hyiger/sbc_z80/README.md

THS-80 Model I - a Z80 single board computer on a RC2014 form-factor card

Requires KiCad 5.1.4 or higher
