hyiger/sbc_z80/sbc_z80.kicad_pcb

## KiCad design sbc_z80.kicad_pcb (2019-09-01)

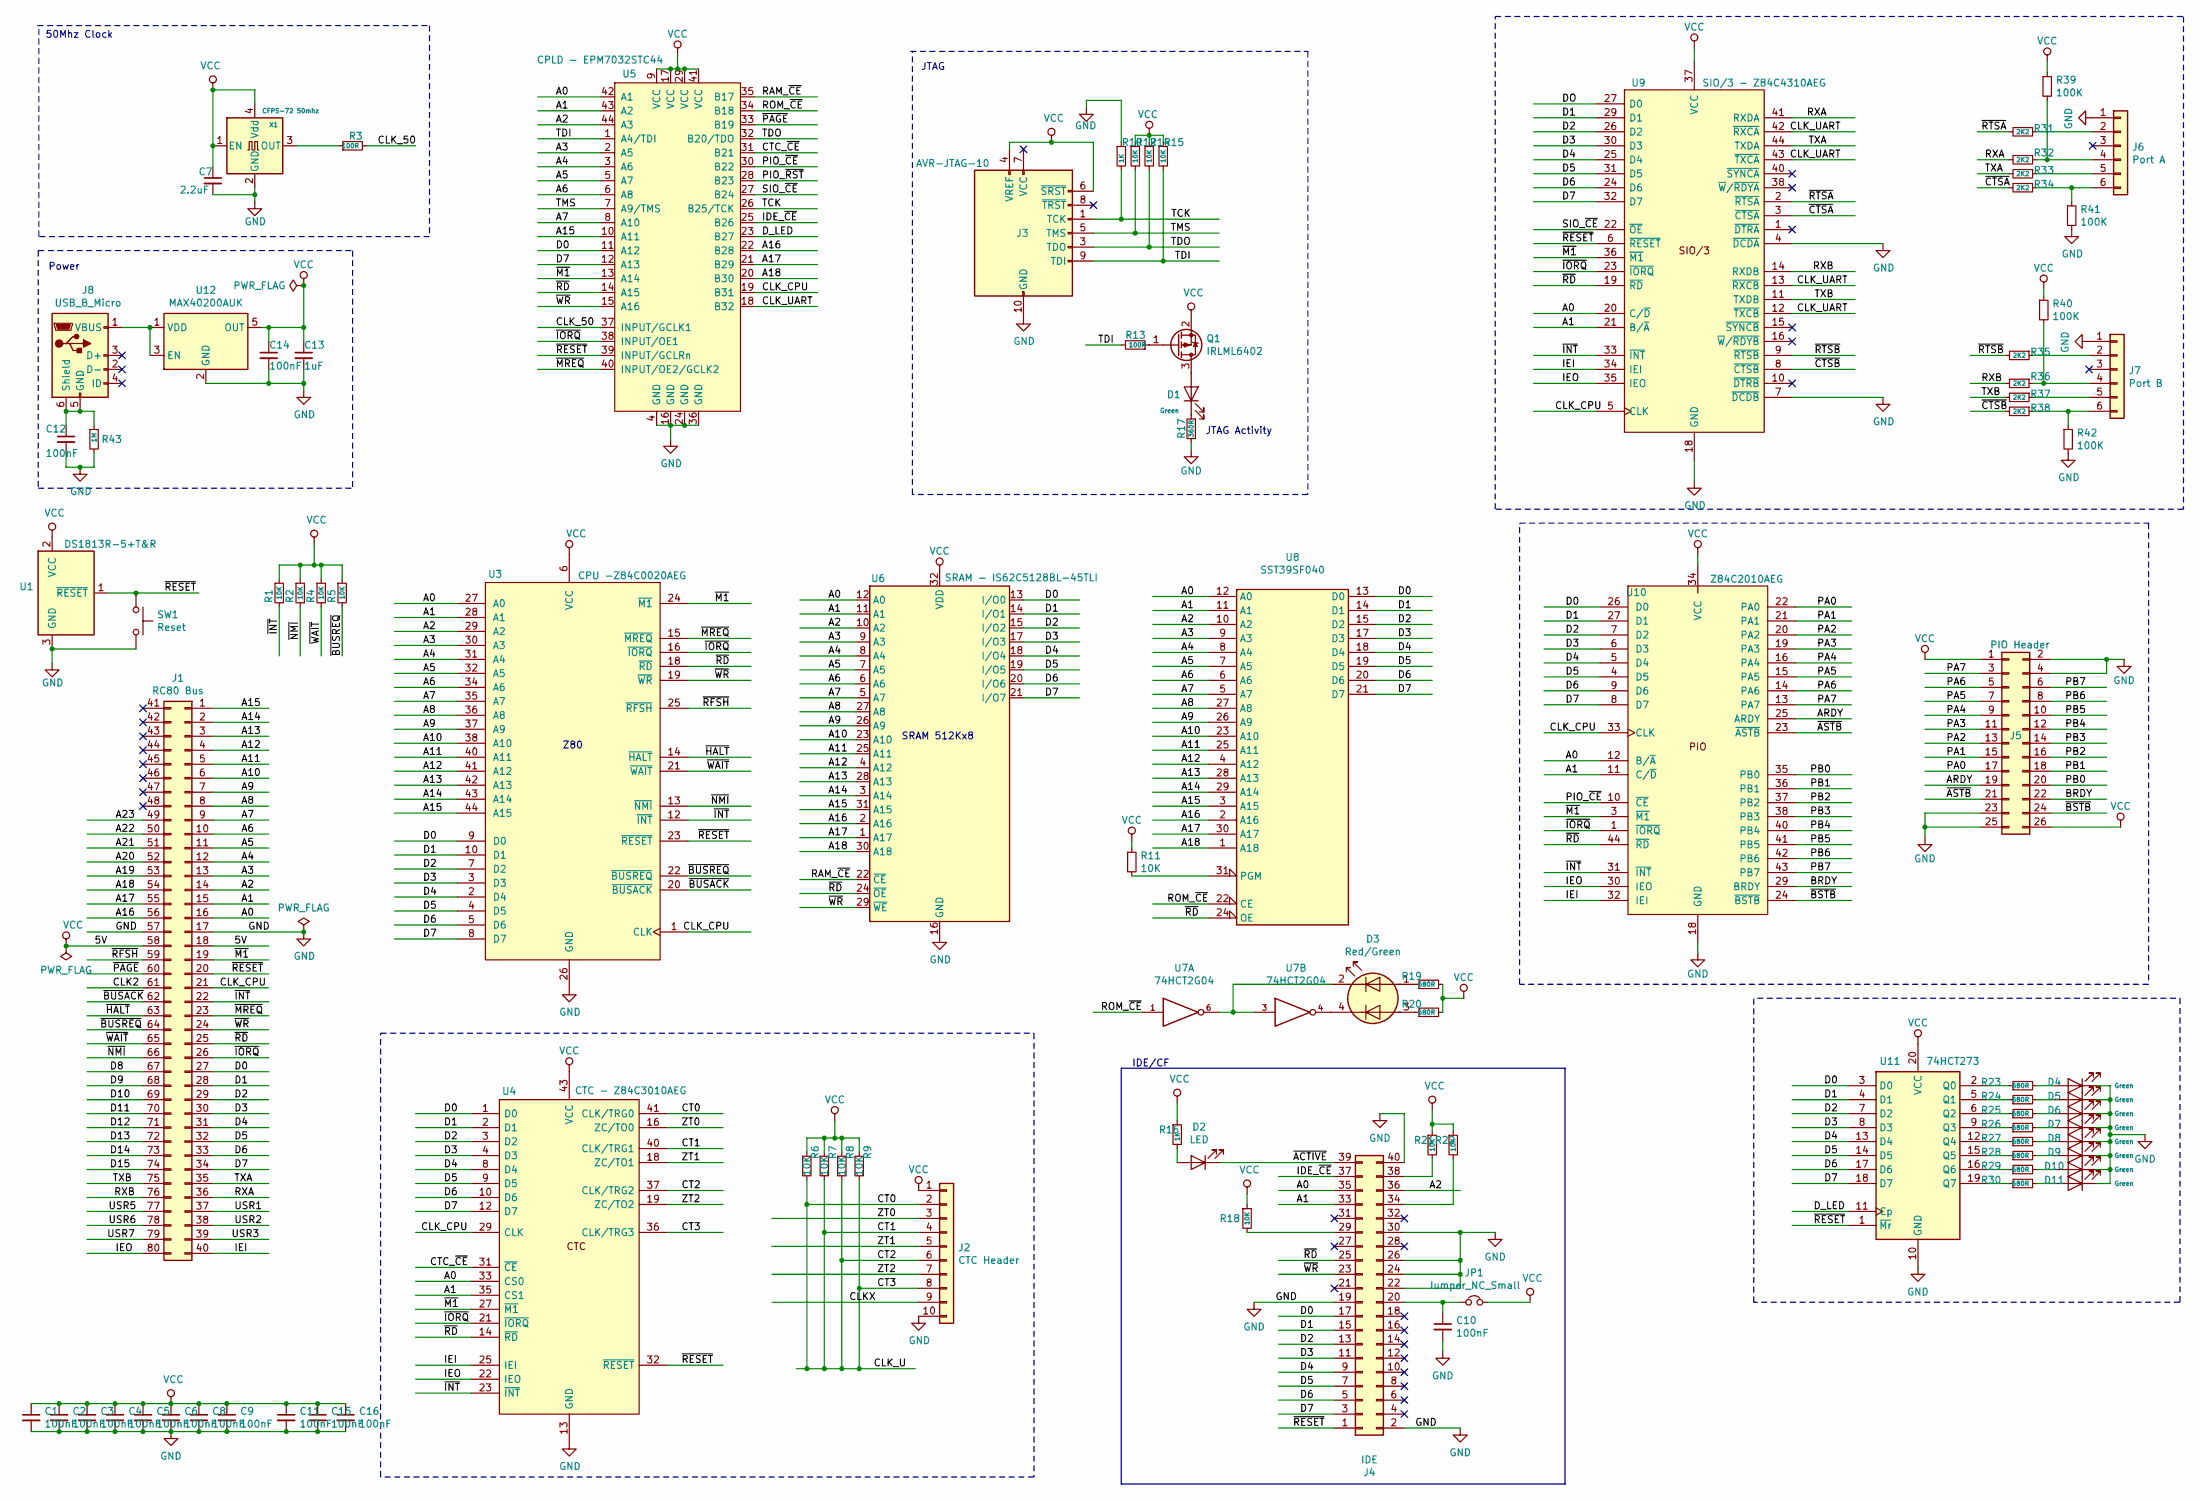
[picture p1: schematic sbc_z80.sch, THS-80]

Parts:
C1, C2, C3, C4, C5, C6, C8, C9, C10, C11, C15, C16: 100nF; C_0603_1608Metric_Pad1.05x0.95mm_HandSolder; MPN JMK107B7474KA-T
C7: 2.2uF; C_0603_1608Metric_Pad1.05x0.95mm_HandSolder; MPN JMK107B7474KA-T
C12, C14: 100nF; C_0603_1608Metric_Pad1.05x0.95mm_HandSolder; MPN C0805C105K4RACTU
C13: 1uF; C_0603_1608Metric_Pad1.05x0.95mm_HandSolder; MPN C0805C105K4RACTU
D1, D4, D5, D6, D7, D8, D9, D10, D11: Green; LED_0603_1608Metric_Pad1.05x0.95mm_HandSolder
D2: LED; LED_0603_1608Metric_Pad1.05x0.95mm_HandSolder
D3: Red/Green; LED_2C_0603_1608Metric_Pad1.05x0.95mm_HandSolder
J1: RC80 Bus; PinHeader_2x40_Top_Bottom_P2.54mm_Horizontal
J2: CTC Header; PinHeader_1x10_P2.54mm_Horizontal
J3: AVR-JTAG-10; PinHeader_2x05_P2.54mm_Vertical
J4: IDE; PinHeader_2x20_P2.54mm_Horizontal
J5: PIO Header; PinHeader_2x13_P2.54mm_Horizontal
J6: Port A; PinHeader_1x06_P2.54mm_Horizontal
J7: Port B; PinHeader_1x06_P2.54mm_Horizontal
J8: USB_B_Micro; USB_Micro-B_Molex-105017-0001; MPN 10103594-0001LF
JP1: Jumper_NC_Small; PinHeader_1x02_P2.54mm_Vertical
Q1: IRLML6402; SOT-23
R1, R2, R4, R5, R6, R7, R8, R9, R11, R12, R14, R15, R18, R21, R22: 10K; R_0603_1608Metric_Pad1.05x0.95mm_HandSolder
R3, R13: 100R; R_0603_1608Metric_Pad1.05x0.95mm_HandSolder
R10, R16: 1K; R_0603_1608Metric_Pad1.05x0.95mm_HandSolder
R17: 360R; R_0603_1608Metric_Pad1.05x0.95mm_HandSolder
R19, R20, R23, R24, R25, R26, R27, R28, R29, R30: 680R; R_0603_1608Metric_Pad1.05x0.95mm_HandSolder; MPN RC0603JR-071KL
R31, R32, R33, R34, R35, R36, R37, R38: 2K2; R_0603_1608Metric_Pad1.05x0.95mm_HandSolder
R39, R40, R41, R42: 100K; R_0603_1608Metric_Pad1.05x0.95mm_HandSolder
R43: 1M; R_0603_1608Metric_Pad1.05x0.95mm_HandSolder
SW1: Reset; SW_Push_SPST_NO_Alps_SKRK
U1: DS1813R-5+T&R; SOT-23
U3: CPU -Z84C0020AEG; LQFP-44_10x10mm_P0.8mm; Manufacturer_Part_Number Z84C0010AEG
U4: CTC - Z84C3010AEG; LQFP-44_10x10mm_P0.8mm; Manufacturer_Part_Number Z84C4310AEG
U5: CPLD - EPM7032STC44; TQFP-44_10x10mm_P0.8mm
U6: SRAM - IS62C5128BL-45TLI; TSOP-II-32_21.0x10.2mm_P1.27mm
U7: 74HCT2G04; TSOP-6_1.65x3.05mm_P0.95mm
U8: SST39SF040; PLCC-32_SMD-Socket
U9: SIO/3 - Z84C4310AEG; LQFP-44_10x10mm_P0.8mm; Manufacturer_Part_Number Z84C4310AEG
U10: Z84C2010AEG; LQFP-44_10x10mm_P0.8mm; Manufacturer_Part_Number Z84C2010AEG
U11: 74HCT273; TSSOP-20_4.4x6.5mm_P0.65mm
U12: MAX40200AUK; SOT-23-5_HandSoldering; MPN MAX40200AUK+T; Mouser  PN 700-MAX40200AUK+T
X1: CFPS-72 50mhz; Oscillator_SMD_SeikoEpson_SG8002CA-4Pin_7.0x5.0mm_HandSolde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

Connections:
/A0: J1.16, J4.35, U3.27 (A0), U4.33 (CS0), U5.42 (A1), U6.12 (A0), U8.12 (A0), U9.20 (C/~D), U10.12 (B/~A)
/A1: J1.15, J4.33, U3.28 (A1), U4.35 (CS1), U5.43 (A2), U6.11 (A1), U8.11 (A1), U9.21 (B/~A), U10.11 (C/~D)
/A2: J1.14, J4.36, U3.29 (A2), U5.44 (A3), U6.10 (A2), U8.10 (A2)
/A3: J1.13, U3.30 (A3), U5.2 (A5), U6.9 (A3), U8.9 (A3)
/A4: J1.12, U3.31 (A4), U5.3 (A6), U6.8 (A4), U8.8 (A4)
/A5: J1.11, U3.32 (A5), U5.5 (A7), U6.7 (A5), U8.7 (A5)
/A6: J1.10, U3.34 (A6), U5.6 (A8), U6.6 (A6), U8.6 (A6)
/A7: J1.9, U3.35 (A7), U5.8 (A10), U6.5 (A7), U8.5 (A7)
/A8: J1.8, U3.36 (A8), U6.27 (A8), U8.27 (A8)
/A9: J1.7, U3.37 (A9), U6.26 (A9), U8.26 (A9)
/A10: J1.6, U3.38 (A10), U6.23 (A10), U8.23 (A10)
/A11: J1.5, U3.40 (A11), U6.25 (A11), U8.25 (A11)
/A12: J1.4, U3.41 (A12), U6.4 (A12), U8.4 (A12)
/A13: J1.3, U3.42 (A13), U6.28 (A13), U8.28 (A13)
/A14: J1.2, U3.43 (A14), U6.3 (A14), U8.29 (A14)
/A15: J1.1, U3.44 (A15), U5.10 (A11), U6.31 (A15), U8.3 (A15)
/A16: J1.56, U5.22 (B28), U6.2 (A16), U8.2 (A16)
/A17: J1.55, U5.21 (B29), U6.1 (A17), U8.30 (A17)
/A18: J1.54, U5.20 (B30), U6.30 (A18), U8.1 (A18)
/A19: J1.53
/A20: J1.52
/A21: J1.51
/A22: J1.50
/A23: J1.49
/ARDY: J5.19, U10.25 (ARDY)
/BRDY: J5.22, U10.29 (BRDY)
/CLK2: J1.61
/CLKX: J2.9
/CLK_50: R3.2, U5.37 (INPUT/GCLK1)
/CLK_CPU: J1.21, U3.1 (CLK), U4.29 (CLK), U5.19 (B31), U9.5 (CLK), U10.33 (CLK)
/CLK_U: J2.2, J2.4, J2.6, J2.8, R6.2, R7.2, R8.2, R9.2, U4.36 (CLK/TRG3), U4.37 (CLK/TRG2), U4.40 (CLK/TRG1), U4.41 (CLK/TRG0)
/CLK_UART: U5.18 (B32), U9.12 (~TXCB), U9.13 (~RXCB), U9.42 (~RXCA), U9.43 (~TXCA)
/CTC_~CE~: U4.31 (~CE), U5.31 (B21)
/D0: J1.27, J4.17, U3.9 (D0), U4.1 (D0), U5.11 (A12), U6.13 (I/O0), U8.13 (D0), U10.26 (D0), U11.3 (D0)
/D1: J1.28, J4.15, U3.10 (D1), U4.2 (D1), U6.14 (I/O1), U8.14 (D1), U9.29 (D1), U10.27 (D1), U11.4 (D1)
/D2: J1.29, J4.13, U3.7 (D2), U4.3 (D2), U6.15 (I/O2), U8.15 (D2), U9.26 (D2), U10.7 (D2), U11.7 (D2)
/D3: J1.30, J4.11, U3.3 (D3), U4.4 (D3), U6.17 (I/O3), U8.17 (D3), U9.30 (D3), U10.6 (D3), U11.8 (D3)
/D4: J1.31, J4.9, U3.2 (D4), U4.8 (D4), U6.18 (I/O4), U8.18 (D4), U9.25 (D4), U10.5 (D4), U11.13 (D4)
/D5: J1.32, J4.7, U3.4 (D5), U4.9 (D5), U6.19 (I/O5), U8.19 (D5), U9.31 (D5), U10.4 (D5), U11.14 (D5)
/D6: J1.33, J4.5, U3.5 (D6), U4.10 (D6), U6.20 (I/O6), U8.20 (D6), U9.24 (D6), U10.9 (D6), U11.17 (D6)
/D7: J1.34, J4.3, U3.8 (D7), U4.12 (D7), U5.12 (A13), U6.21 (I/O7), U8.21 (D7), U9.32 (D7), U10.8 (D7), U11.18 (D7)
/D8: J1.67
/D9: J1.68
/D10: J1.69
/D11: J1.70
/D12: J1.71
/D13: J1.72
/D14: J1.73
/D15: J1.74
/DO: U9.27 (D0)
/D_LED: U5.23 (B27), U11.11 (Cp)
/IDE_~CE~: J4.37, U5.25 (B26)
/IEI: J1.40, U4.25 (IEI), U9.34 (IEI), U10.32 (IEI)
/IEO: J1.80, U4.22 (IEO), U9.35 (IEO), U10.30 (IEO)
/PA0: J5.17, U10.22 (PA0)
/PA1: J5.15, U10.21 (PA1)
/PA2: J5.13, U10.20 (PA2)
/PA3: J5.11, U10.19 (PA3)
/PA4: J5.9, U10.16 (PA4)
/PA5: J5.7, U10.15 (PA5)
/PA6: J5.5, U10.14 (PA6)
/PA7: J5.3, U10.13 (PA7)
/PB0: J5.20, U10.35 (PB0)
/PB1: J5.18, U10.36 (PB1)
/PB2: J5.16, U10.37 (PB2)
/PB3: J5.14, U10.38 (PB3)
/PB4: J5.12, U10.40 (PB4)
/PB5: J5.10, U10.41 (PB5)
/PB6: J5.8, U10.42 (PB6)
/PB7: J5.6, U10.43 (PB7)
/PIO_~CE~: U5.30 (B22), U10.10 (~CE)
/PIO_~RST~: U5.28 (B23)
/RAM_~CE~: U5.35 (B17), U6.22 (~CE)
/ROM_~CE~: U5.34 (B18), U7.1, U8.22 (CE)
/RXA: J1.36, R32.2, U9.41 (RXDA)
/RXB: J1.76, R36.2, U9.14 (RXDB)
/SIO_~CE~: U5.27 (B24), U9.22 (~OE)
/TCK: J3.1 (TCK), R10.2, U5.26 (B25/TCK)
/TDI: J3.9 (TDI), R13.2, R15.2, U5.1 (A4/TDI)
/TDO: J3.3 (TDO), R14.2, U5.32 (B20/TDO)
/TMS: J3.5 (TMS), R12.2, U5.7 (A9/TMS)
/TXA: J1.35, R33.2, U9.44 (TXDA)
/TXB: J1.75, R37.2, U9.11 (TXDB)
/USR1: J1.37
/USR2: J1.38
/USR3: J1.39
/USR5: J1.77
/USR6: J1.78
/USR7: J1.79
/ZT0: J2.3, U4.16 (ZC/TO0)
/ZT1: J2.5, U4.18 (ZC/TO1)
/ZT2: J2.7, U4.19 (ZC/TO2)
/~ACTIVE: D2.1 (K), J4.39
/~ASTB: J5.21, U10.23 (~ASTB)
/~BSTB: J5.24, U10.24 (~BSTB)
/~BUSACK: J1.62, U3.20 (~BUSACK)
/~BUSREQ: J1.64, R5.2, U3.22 (~BUSREQ)
/~CTSA: R34.2, U9.3 (~CTSA)
/~CTSB: R38.2, U9.8 (~CTSB)
/~HALT: J1.63, U3.14 (~HALT)
/~INT: J1.22, R1.2, U3.12 (~INT), U4.23 (~INT), U9.33 (~INT), U10.31 (~INT)
/~IORQ: J1.26, U3.16 (~IORQ), U4.21 (~IORQ), U5.38 (INPUT/OE1), U9.23 (~IORQ), U10.1 (~IORQ)
/~M1: J1.19, U3.24 (~M1), U4.27 (~M1), U5.13 (A14), U9.36 (~M1), U10.3 (~M1)
/~MREQ: J1.23, U3.15 (~MREQ), U5.40 (INPUT/OE2/GCLK2)
/~NMI: J1.66, R2.2, U3.13 (~NMI)
/~PAGE: J1.60, U5.33 (B19)
/~RD: J1.25, J4.25, U3.18 (~RD), U4.14 (~RD), U5.14 (A15), U6.24 (~OE), U8.24 (OE), U9.19 (~RD), U10.44 (~RD)
/~RESET: J1.20, J4.1, SW1.1, U1.1 (~RESET~), U3.23 (~RESET), U4.32 (~RESET), U5.39 (INPUT/GCLRn), U9.6 (~RESET), U11.1 (~Mr)
/~RFSH: J1.59, U3.25 (~RFSH)
/~RTSA: R31.2, U9.2 (~RTSA)
/~RTSB: R35.2, U9.9 (~RTSB)
/~WAIT: J1.65, R4.2, U3.21 (~WAIT)
/~WR: J1.24, J4.23, U3.19 (~WR), U5.15 (A16), U6.29 (~WE)
GND: C1.2, C2.2, C3.2, C4.2, C5.2, C6.2, C7.2, C8.2, C9.2, C10.2, C11.2, C12.2, C13.2, C14.2, C15.2, C16.2, D4.1 (K), D5.1 (K), D6.1 (K), D7.1 (K), D8.1 (K), D9.1 (K), D10.1 (K), D11.1 (K), J1.17, J1.57, J2.10, J3.2 (GND), J3.10 (GND), J4.2, J4.19, J4.22, J4.24, J4.26, J4.30, J4.40, J5.2, J5.4, J5.23, J5.25, J6.1, J7.1, R10.1, R17.2, R41.2, R42.2, R43.2, SW1.2, U1.3 (GND), U3.26 (GND), U4.13 (GND), U5.4 (GND), U5.16 (GND), U5.24 (GND), U5.36 (GND), U6.16 (GND), U7.2 (GND), U8.16 (GND), U9.4 (~DCDA), U9.7 (~DCDB), U9.18 (GND), U10.18 (GND), U11.10 (GND), U12.2 (GND), X1.2 (GND)
unnamed: C10.1, J4.20, JP1.1
unnamed: C12.1, J8.5 (GND), J8.6 (Shield), R43.1
unnamed: D1.1 (K), R17.1
unnamed: D1.2 (A), Q1.3 (D)
unnamed: D2.2 (A), R16.2
unnamed: D3.1 (A1), R19.1
unnamed: D3.2 (K1), U7.3, U7.6
unnamed: D3.3 (A2), R20.1
unnamed: D3.4 (K2), U7.4
unnamed: D4.2 (A), R23.2
unnamed: D5.2 (A), R24.2
unnamed: D6.2 (A), R25.2
unnamed: D7.2 (A), R26.2
unnamed: D8.2 (A), R27.2
unnamed: D9.2 (A), R28.2
unnamed: D10.2 (A), R29.2
unnamed: D11.2 (A), R30.2
unnamed: J4.29, R18.2
unnamed: J4.34, R22.2
unnamed: J4.38, R21.2
unnamed: J6.2, R31.1
unnamed: J6.4, R32.1, R39.2
unnamed: J6.5, R33.1
unnamed: J6.6, R34.1, R41.1
unnamed: J7.2, R35.1
unnamed: J7.4, R36.1, R40.2
unnamed: J7.5, R37.1
unnamed: J7.6, R38.1, R42.1
unnamed: J8.1 (VBUS), U12.1 (VDD), U12.3 (EN)
unnamed: Q1.1 (G), R13.1
unnamed: R3.1, X1.3 (OUT)
unnamed: R11.2, U8.31 (PGM)
unnamed: R23.1, U11.2 (Q0)
unnamed: R24.1, U11.5 (Q1)
unnamed: R25.1, U11.6 (Q2)
unnamed: R26.1, U11.9 (Q3)
unnamed: R27.1, U11.12 (Q4)
unnamed: R28.1, U11.15 (Q5)
unnamed: R29.1, U11.16 (Q6)
unnamed: R30.1, U11.19 (Q7)
VCC: C1.1, C2.1, C3.1, C4.1, C5.1, C6.1, C7.1, C8.1, C9.1, C11.1, C13.1, C14.1, C15.1, C16.1, J1.18, J1.58, J2.1, J3.4 (VREF), J3.6 (~SRST), J5.1, J5.26, JP1.2, Q1.2 (S), R1.1, R2.1, R4.1, R5.1, R6.1, R7.1, R8.1, R9.1, R11.1, R12.1, R14.1, R15.1, R16.1, R18.1, R19.2, R20.2, R21.1, R22.1, R39.1, R40.1, U1.2 (VCC), U3.6 (VCC), U4.43 (VCC), U5.9 (VCC), U5.17 (VCC), U5.29 (VCC), U5.41 (VCC), U6.32 (VDD), U7.5 (VCC), U8.32 (VCC), U9.37 (VCC), U10.34 (VCC), U11.20 (VCC), U12.5 (OUT), X1.1 (EN), X1.4 (Vdd)

Notes on the sheet:
SRAM 512Kx8
Z80
50Mhz Clock
JTAG
JTAG Activity
IDE/CF
Power

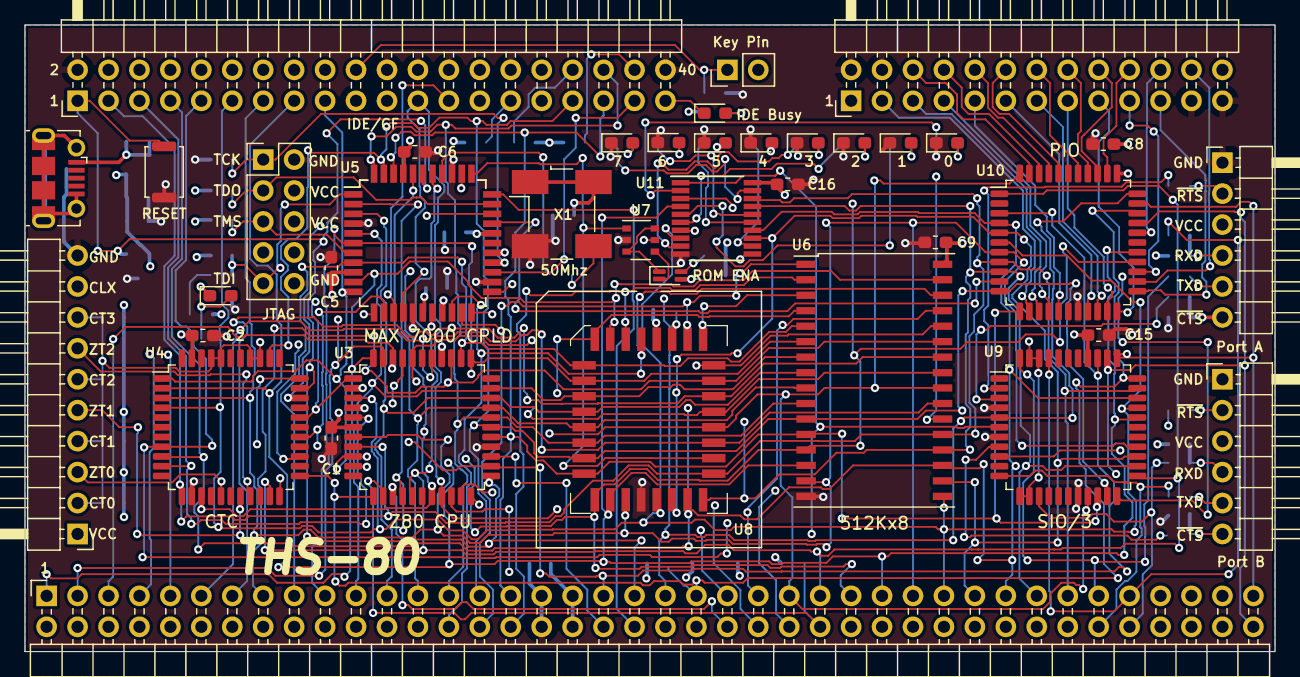
[picture p2: board sbc_z80.kicad_pcb from above]

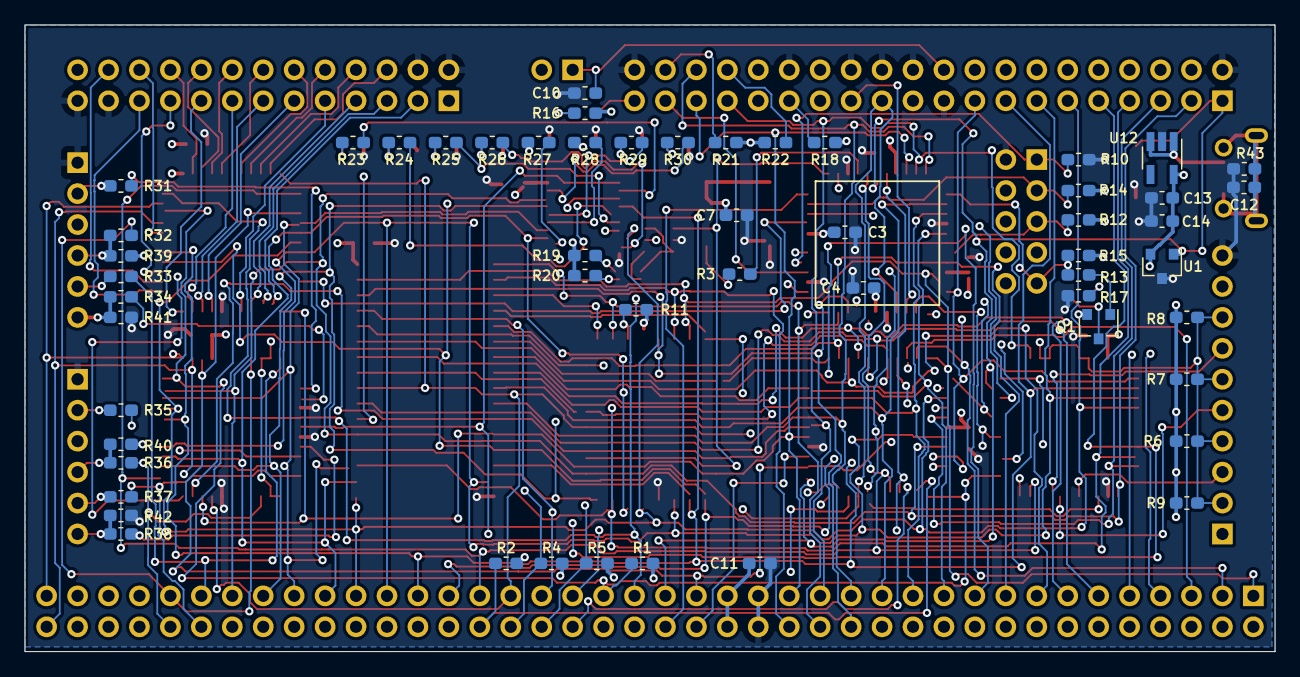
[picture p3: board sbc_z80.kicad_pcb from below]

Board: 4 copper layers, 102.6 x 51.4 mm, 93 parts (54 on the bottom side), 132 nets.
