hyiger/sbc_z80/(commit log)

2019-06-24 initial revision
    [clocks.sch, sbc_z80.kicad_pcb, sbc_z80.sch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]
2019-06-25 added 3V3 section for clock generator
    [clocks.sch, sbc_z80.kicad_pcb, sbc_z80.sch]
2019-06-26 larger sheet, connected more pins
    [PIO.sch, clocks.sch, sbc_z80.kicad_pcb, sbc_z80.sch]
2019-06-27 started routing
    [sbc_z80.kicad_pcb, sbc_z80.sch]
2019-06-28 fixed up ce signals
    [sbc_z80.kicad_pcb, sbc_z80.sch]
2019-07-01 reordered resistors
    [clocks.sch, sbc_z80.kicad_pcb, sbc_z80.sch]
2019-07-05 changed part layouts
    [clocks.sch, sbc_z80.kicad_pcb, sbc_z80.sch]
2019-07-11 added display, config switch
    [clocks.sch, sbc_z80.kicad_pcb, sbc_z80.sch]
2019-07-12 fixed NC pins
    [clocks.sch, sbc_z80.kicad_pcb, sbc_z80.sch]
2019-07-15 code for max7000 glue logic
    [clocks.sch, sbc_z80.sch]
2019-07-16 add i2c master
2019-07-31 fixed pins
    [clocks.sch, sbc_z80.sch]
2019-08-06 changed part layout, removed switch
    [clocks.sch, sbc_z80.kicad_pcb, sbc_z80.sch]
2019-08-07 added USB power, fixed layout
    [sbc_z80.kicad_pcb, sbc_z80.sch]
2019-08-08 address lines routed
    [sbc_z80.kicad_pcb]
2019-08-09 more routing
    [sbc_z80 3.kicad_pcb, sbc_z80.kicad_pcb, sbc_z80.sch]
2019-08-13 passed drc
    [sbc_z80.kicad_pcb, sbc_z80.sch]
2019-08-13 fixed layout, added labels
    [sbc_z80.kicad_pcb, sbc_z80.sch]
2019-09-01 update zone-fills to latest nightly
    [sbc_z80.kicad_pcb]
